hoangminhbmt-hub/xedap/diagrams/xedap-so-do-noi-day.png

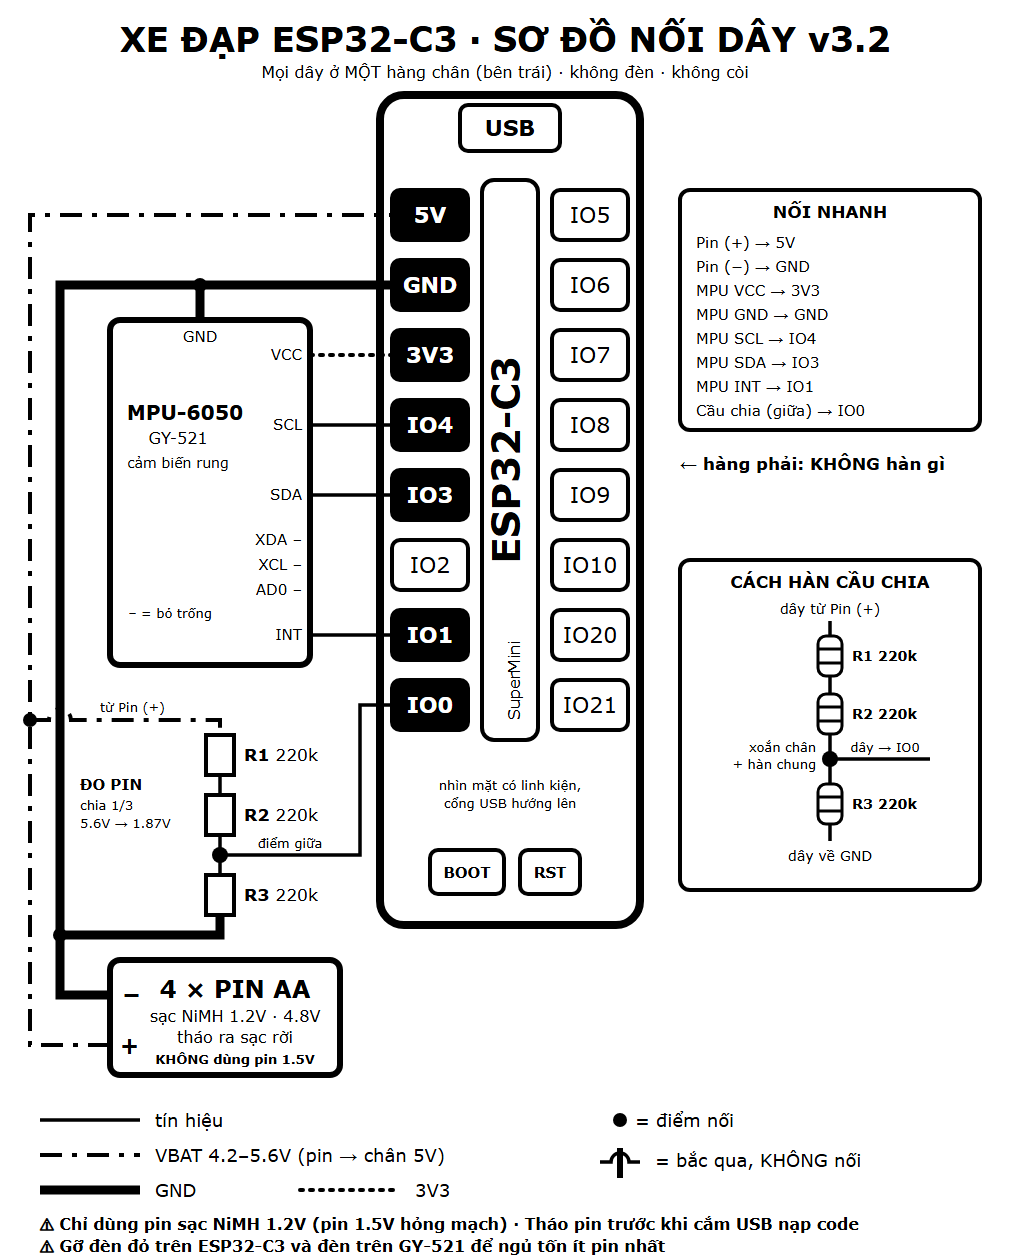
diagrams/xedap-so-do-noi-day.png
