hoangminhbmt-hub/xedap/(commit log)

2026-11-12 Firmware XeDap v3.2: tắt hẳn LED xanh, tự dò lại cảm biến rung
    - LED xanh trên mạch (GPIO8) giữ mức HIGH để tắt hẳn, hết nháy khi phát Bluetooth
    - Không thấy MPU lúc khởi động hoặc bị tuột giữa chừng: tự dò lại mỗi 5 giây
    - Mã PIN mặc định để 123456, đổi thành mã của bạn trước khi nạp
2026-11-12 Thêm README: phần cứng, nối dây, nạp firmware, cách dùng
2026-11-12 Thêm sơ đồ nối dây (SVG + PNG), hiện trong README
2026-11-12 Sơ đồ nối dây: đổi số phiên bản v2.3 -> v3.2 cho khớp firmware
2026-11-13 Ghi chu XeGuard la ban cu; them .gitignore
